danja/chatterbox/links.md

## Chatterbox Links/References

*Some are local copies, see [/reference](https://github.com/danja/chatterbox/tree/master/reference)*

### Formant-based Speech Synthesis
* [Chatterbox](https://github.com/danja/chatterbox/blob/master/reference/Chatterbox-1976.pdf)  [Witten & Madams, 1978]

* [The Source-Filter Model of Speech Production](http://www.phon.ox.ac.uk/jcoleman/source_filter.htm)
* [Formant (Wikipedia)](https://en.wikipedia.org/wiki/Formant)
* [Analysis, synthesis, and perception of voice quality variations among female and male talkers](http://www.fon.hum.uva.nl/david/ma_ssp/doc/Klatt-1990-JAS000820.pdf)
* [Software for a cascade/parallel formant synthesizer](http://www.fon.hum.uva.nl/david/ma_ssp/doc/Klatt-1980-JAS000971.pdf)

*Dennis H. Klatt, the author of the two papers above has [a wealth of other related material](https://www.researchgate.net/scientific-contributions/2033647470_Dennis_H_Klatt)*

* [eSpeakNG](https://github.com/espeak-ng/espeak-ng) - mature open-source project for formant-based speech synthesis
* [Faust](https://faust.grame.fr/)

* [Linear predictive coding](https://en.wikipedia.org/wiki/Linear_predictive_coding)
* Speak & Spell

### Speech
* [Source-Filter Model](https://github.com/danja/chatterbox/blob/master/references/source-filter.pdf)
* [Speech Synthesis and Recognition - local](https://github.com/danja/chatterbox/blob/master/reference/speech-synthesis-and-recognition_book.pdf), [remote copy](https://epdf.pub/queue/speech-synthesis-and-recognition.html) (book)

###  Speech Processing Lecture Slides (very wide in scope, but good summaries of each bit)
From Texas A&M University, CSCE 689-604: Special Topics in Speech Processing, [cource material](http://courses.cs.tamu.edu/rgutier/csce689_s11/)

* L1 : [Course Introduction](http://research.cs.tamu.edu/prism/lectures/sp/l1.pdf)
* L2 : [Speech production and perception](http://research.cs.tamu.edu/prism/lectures/sp/l2.pdf)
* L3 : [Organization of speech sounds](http://research.cs.tamu.edu/prism/lectures/sp/l3.pdf) - good overview slides
* L4 : [Signals and transforms](http://research.cs.tamu.edu/prism/lectures/sp/l4.pdf) (slides)
* L5 : [Digital filters](http://research.cs.tamu.edu/prism/lectures/sp/l5.pdf) (slides)
* L6 : [Short-time Fourier analysis and synthesis](http://research.cs.tamu.edu/prism/lectures/sp/l6.pdf) (slides)
* L7 : [Linear prediction of speech](http://research.cs.tamu.edu/prism/lectures/sp/l7.pdf)
* L8 : [Source estimation](http://research.cs.tamu.edu/prism/lectures/sp/l8.pdf)
* L9 : [Cepstral analysis](http://research.cs.tamu.edu/prism/lectures/sp/l9.pdf)
* L10 : [Probability, statistics, and estimation theory](http://research.cs.tamu.edu/prism/lectures/sp/l10.pdf)
* L11 : [Pattern recognition principles](http://research.cs.tamu.edu/prism/lectures/sp/l11.pdf)
* L12 : [Template matching](http://research.cs.tamu.edu/prism/lectures/sp/l12.pdf)
* L13 : [hidden Markov models](http://research.cs.tamu.edu/prism/lectures/sp/l13.pdf)
* L14 : [Refinements for HMMs](http://research.cs.tamu.edu/prism/lectures/sp/l14.pdf)
* L15 : [Large vocabulary continuous speech recognition](http://research.cs.tamu.edu/prism/lectures/sp/l15.pdf)
* L16 : [Speaker recognition](http://research.cs.tamu.edu/prism/lectures/sp/l16.pdf)
* L17 : [Speech synthesis (front-end)](http://research.cs.tamu.edu/prism/lectures/sp/l17.pdf)
* L18 : [Speech synthesis (back end)](http://research.cs.tamu.edu/prism/lectures/sp/l18.pdf)
* L19 : [Prosodic modification of speech](http://research.cs.tamu.edu/prism/lectures/sp/l19.pdf)
* L20 : [Voice Conversion](http://research.cs.tamu.edu/prism/lectures/sp/l20.pdf)
* L21 : [HTK](http://research.cs.tamu.edu/prism/lectures/sp/l21.pdf) (HTK is a toolkit for building Hidden Markov Models primarily designed for building speech recognizers)

* [Voice Acoustics](https://newt.phys.unsw.edu.au/jw/speech.html)
* [Voice Acoustics: an introduction](https://newt.phys.unsw.edu.au/jw/voice.html)
* [Phonetics](https://home.cc.umanitoba.ca/~krussll/phonetics/index.html)

* [Acoustic structure of consonants](http://www.phon.ox.ac.uk/jcoleman/consonant_acoustics.htm)
* [Gunnar Fant Publications](http://www.speech.kth.se/gunnarfant/publications.html)
* [A Four-Parameter Model of Glottal Flow](https://www.researchgate.net/publication/243630331_A_Four-Parameter_Model_of_Glottal_Flow) (*LF-model*)
* [The LF-model revisited. Transformations and frequency domain analysis](https://citeseerx.ist.psu.edu/viewdoc/download?doi=10.1.1.184.6321&rep=rep1&type=pdf)
* [LF-frequency domain analysis](http://www.speech.kth.se/prod/publications/files/qpsr/1996/1996_37_2_135-138.pdf)

* [Are Measured Differences Between the Formants of Men, Women and Children Due to FO Differences?](https://core.ac.uk/download/pdf/85221943.pdf)
* [Relative contribution of envelope and fine structure to the subcortical encoding of noise-degraded speech](https://asa.scitation.org/doi/10.1121/1.4965248)
* [Temporal information in speech: acoustic, auditory and linguistic aspects](https://royalsocietypublishing.org/doi/pdf/10.1098/rstb.1992.0070)
* [Dynamics: The Third Dimension of Speech](https://www.audiologyonline.com/articles/dynamics-third-dimension-speech-813)

* [Spectral balance as an acoustic correlate of linguistic stress](https://www.researchgate.net/publication/14340446_Spectral_tilt_as_an_acoustic_correlate_of_linguistic_stress)
* [Detection of shouted speech in noise: Human and machine](https://users.aalto.fi/~jpohjala/publications/JASMAN13342377_1.pdf)
* [Sopranos: resonance tuning and vowel changes](https://newt.phys.unsw.edu.au/jw/soprane.html)
* [FORENSIC ANALYSIS OF THE AUDIBILITY OF FEMALE SCREAMS ](http://www.audioforensics.com/PDFs/AES122_Scream.pdf)
* [Modeling and Analyzing the Vocal TRact under Normal and Stressful Talking Conditions](https://arxiv.org/pdf/1707.00149.pdf)
* [On chaotic nature of speech signals](https://www.researchgate.net/publication/23678739_On_chaotic_nature_of_speech_signals)

## DSP
**Online Books**
* [Mathematics of the Discrete Fourier Transform (DFT)](https://ccrma.stanford.edu/~jos/mdft/)
* [Introduction to Digital Filters](https://ccrma.stanford.edu/~jos/filters/) (uses MATLAB)
* [Physical Audio Signal Processing](https://ccrma.stanford.edu/~jos/pasp/)
* [Spectral Audio Signal Processing](https://ccrma.stanford.edu/~jos/sasp/)

### Wavetables etc.
* [the_synth](https://github.com/dzlonline/the_synth)
* [Alias-Free Digital Synthesis of Classic Analog Waveforms](https://ccrma.stanford.edu/~stilti/papers/blit.pdf)
* [Table Lookup Oscillators Using Generic Integrated Wavetables](http://mtg.upf.edu/node/485)

* [Pink Noise bits](https://dsp.stackexchange.com/questions/322/pink-1-f-pseudo-random-noise-generation/56820#56820)

### Filters
* [Digital Filters For Music Synthesis](https://github.com/danja/chatterbox/blob/master/reference/karmafx_digitalfilters.pdf)
* [musicdsp.org](https://www.musicdsp.org/)
* [KVR Forum](https://www.kvraudio.com/forum/)
* [Biquads](https://www.earlevel.com/main/2003/02/28/biquads/) (blog - a lot of other stuff)
* [The digital state variable filter](https://www.earlevel.com/main/2003/03/02/the-digital-state-variable-filter/)
* [Introduction to Digital Filters with Audio Applications](https://ccrma.stanford.edu/~jos/filters/)
* [A Collection of Useful C++ Classes for Digital Signal Processing](https://github.com/vinniefalco/DSPFilters)
* [DSP Tips & Tricks](https://web.archive.org/web/20070427190833/http://www.cspl.umd.edu/spm/tips-n-tricks/)

* [Cytomic technical papers](https://cytomic.com/technical-papers) (includes the derivation of SvfLinearTrapOptimised2)
* [Common-DSP](https://github.com/FredAntonCorvest/Common-DSP) (includes implementation of SvfLinearTrapOptimised2)

### Fixed-point maths
* [Fixed Point Math Library for C](https://sourceforge.net/p/fixedptc/)
* [related thread on StackOverflow](https://stackoverflow.com/questions/10067510/fixed-point-arithmetic-in-c-programming)

### ESP32
* [ESP32 Projects & Tutorials](https://randomnerdtutorials.com/projects-esp32/)
* [ESP32 Peripherals](https://randomnerdtutorials.com/esp32-pinout-reference-gpios/)
* [ESP32 Pinout Reference: Which GPIO pins should you use?](https://randomnerdtutorials.com/esp32-pinout-reference-gpios/)
* [The best input and output pins on the NodeMCU ESP32 and ESP8266 (YouTube)](https://www.youtube.com/watch?v=c0tMGlJVmkw)
* [ESP32 ADC – Read Analog Values with Arduino IDE](https://randomnerdtutorials.com/esp32-adc-analog-read-arduino-ide/)
* [Using the ESP32 ADC and some of its more advanced functions (YouTube)](https://www.youtube.com/watch?v=RlKMJknsNpo)
* [esp32-dac](https://github.com/wjslager/esp32-dac)
* [ESP32-ADC-Accuracy-Improvement-function](https://github.com/G6EJD/ESP32-ADC-Accuracy-Improvement-function)
* [Polynomial Regression Data Fit](https://arachnoid.com/polysolve/)

* [ESP-IDF Hello World](https://exploreembedded.com/wiki/Hello_World_with_ESP32_Explained)
* [ESP-IDF ADC API](https://docs.espressif.com/projects/esp-idf/en/latest/api-reference/peripherals/adc.html)
* [ESP-DSP](https://github.com/espressif/esp-dsp)
* [ESP32 Parallel Programming](https://home.roboticlab.eu/en/iot-open/getting_familiar_with_your_hardware_rtu_itmo_sut/esp/esp_parallel_programming)
* [Debouncing a Button Press using Interrupts](https://www.switchdoc.com/2018/04/esp32-tutorial-debouncing-a-button-press-using-interrupts/)

### ESP32/HTTP
* [ESP32 Arduino: Asynchronous HTTP web server](https://techtutorialsx.com/2017/12/01/esp32-arduino-asynchronous-http-webserver/)
* [ESP32 Web Server using SPIFFS (SPI Flash File System)](https://randomnerdtutorials.com/esp32-web-server-spiffs-spi-flash-file-system/)
* [Install ESP32 Filesystem Uploader in Arduino IDE](https://randomnerdtutorials.com/install-esp32-filesystem-uploader-arduino-ide/)
* [Async Web Server for ESP8266 and ESP32](https://github.com/me-no-dev/ESPAsyncWebServer)
* [Async TCP Library for ESP32](https://github.com/me-no-dev/AsyncTCP)
* [ESP32 HTTP webserver: receiving textual data in websocket](https://techtutorialsx.com/2018/08/23/esp32-http-webserver-receiving-textual-data-in-websocket/)

### DAC
[UDA1334ATS Info](https://lcav.gitbook.io/dsp-labs/passthrough/audio-io/dac)

/// unsorted

https://www2.ling.su.se/staff/hartmut/T_1988_phonetica.pdf

http://www.speech.kth.se/gunnarfant/publications.html

http://www.phon.ox.ac.uk/jcoleman/consonant_acoustics.htm

https://forum.arduino.cc/index.php?topic=38153.0

https://www.quora.com/How-can-an-IoT-device-connect-to-a-WiFi-network-without-manually-entering-the-password-or-using-a-cable-to-another-device

https://create.arduino.cc/projecthub/chnry/ocs-2-a-digital-semi-modular-synthesizer-733ba9

https://www.soundonsound.com/techniques/synthesizing-wind-instruments?amp

----

https://makezine.com/2017/04/11/how-to-set-up-your-own-lab/

http://www.radiofreerobotron.net/blog/2016/07/06/how-to-zero-delay-state-variable-filter-part-3/

https://www.musicdsp.org/en/latest/Filters/23-state-variable.html

https://music.stackexchange.com/questions/74483/what-does-a-wave-with-all-even-harmonics-sound-like

https://randomnerdtutorials.com/esp32-web-server-spiffs-spi-flash-file-system/

https://techtutorialsx.com/2018/02/03/esp32-arduino-async-server-controlling-http-methods-allowed/amp/

https://randomnerdtutorials.com/esp32-web-server-spiffs-spi-flash-file-system/

https://randomnerdtutorials.com/esp32-web-server-spiffs-spi-flash-file-system/

https://makezine.com/2017/04/11/how-to-set-up-your-own-lab/

https://www.google.com/search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

https://www.fischl.de/projects/

https://newt.phys.unsw.edu.au/jw/graphics/Wolfe-et-al-Source-Filter.png

https://newt.phys.unsw.edu.au/jw/voice.html

https://newt.phys.unsw.edu.au/jw/voice.html

https://en.wikibooks.org/wiki/Sound_Synthesis_Theory/Oscillators_and_Wavetables

https://www.musicdsp.org/en/latest/Synthesis/244-direct-pink-noise-synthesis-with-auto-correlated-generator.html

http://www.fon.hum.uva.nl/praat/

https://github.com/espressif/esp-idf/tree/f91080637c054fa2b4107192719075d237ecc3ec/examples/peripherals/i2s

https://swphonetics.com/praat/introduction/

https://dsp.stackexchange.com/questions/5959/add-odd-even-harmonics-to-signal

https://www.reddit.com/r/esp32/comments/f6kjqh/serial_speed_too_slow_add_a_100nf_capacitor/

https://www.bbc.co.uk/news/av/world-50116478/thirty-mummies-in-wooden-coffins-found-in-egypt
