danja/chatterbox/future/modules.md

displays:

https://www.banggood.com/2_4-Inch-TFT-LCD-Shield-240320-Touch-Board-Display-Module-With-Pen-For-UNO-p-1171082.html

https://www.banggood.com/Geekcreit-3_2-Inch-MEGA2560-Display-Module-HX8357B-480x320-TFT-LCD-Screen-p-1566668.html
