danja/chatterbox/src/phonetics/ipa-examples.md

that	ðæt
difficult	ˈdɪfɪkəlt
you	ju:
which	wɪtʃ
their	ðeəʳ
about	əˈbaʊt
photo	ˈfoʊtoʊ
should	ʃʊd
people	ˈpi:pəl
also	ˈɔ:lsoʊ
between	bɪˈtwi:n
many	ˈmeni
thicker	ˈθɪkəʳ
child	tʃaɪld
hear	hɪəʳ
system	ˈsɪstəm
group	gru:p
number	ˈnʌmbəʳ

however	haʊˈevəʳ
another	əˈnʌðəʳ
again	əˈgen
world	wɜ:ʳld
area	ˈeəriə
psychology	saɪˈkɒlədʒi
course	kɔ:ʳs
company	ˈkʌmpəni
under	ˈʌndəʳ
problem	ˈprɒbləm
never	ˈnevəʳ
service	ˈsɜ:ʳvɪs
something	ˈsʌmθɪŋ
place	pleɪs
point	pɔɪnt
provide	prəˈvaɪd
large	lɑ:ʳdʒ
general	ˈdʒenərəl

always	ˈɔ:lweɪz
next	nekst
quick	kwɪk
nervous	ˈnɜ:ʳvəs
local	ˈloʊkəl
during	ˈdjʊərɪŋ
although	ɔ:lˈðoʊ
who	hu:
example	ɪgˈzæmpəl
rather	ˈræðəʳ
social	ˈsoʊʃəl
write	raɪt
percent	pəʳ ˈsent
guest	gest
both	boʊθ
every	ˈevri
month	mʌnθ
important	ɪmˈpɔ:ʳtənt

head	hed
information	ɪnfəʳ ˈmeɪʃən
question	ˈkwestʃən
business	ˈbɪznɪs
power	ˈpaʊəʳ
change	tʃeɪndʒ
move	mu:v
book	bʊk
development	dɪˈveləpmənt
young	jʌŋ
national	ˈnæʃənəl
water	ˈwɔ:təʳ
yet	jet
perhaps	pəʳ ˈhæps
until	ʌnˈtɪl
control	kənˈtroʊl
include	ɪnˈklu:d
believe	bɪˈli:v

allow	əˈlaʊ
stand	stænd
idea	aɪˈdi:ə
character	ˈkærɪktəʳ
result	rɪˈzʌlt
happen	ˈhæpən
friend	frend
carry	ˈkæri
awful	ˈɔ:fəl
early	ˈɜ:ʳli
view	vju:
himself	hɪmˈself
xerox	ˈzɪərɒks
report	rɪˈpɔ:ʳt
political	pəˈlɪtɪkəl
law	lɔ:
ghost	goʊst
modest	ˈmɒdɪst

person	ˈpɜ:ʳsən
once	wʌns
police	pəˈli:s
lose	lu:z
position	pəˈzɪʃən
industry	ˈɪndəstri
major	ˈmeɪdʒəʳ
build	bɪld
language	ˈlæŋgwɪdʒ
international	ɪntəʳ ˈnæʃənəl
else	els
yeah	jeə
center	ˈsentəʳ
enough	ɪˈnʌf
calm	kɑ:m
color	ˈkʌləʳ
lure	lʊəʳ
knife	naɪf
