danja/chatterbox/analysis/praat-fooood.png

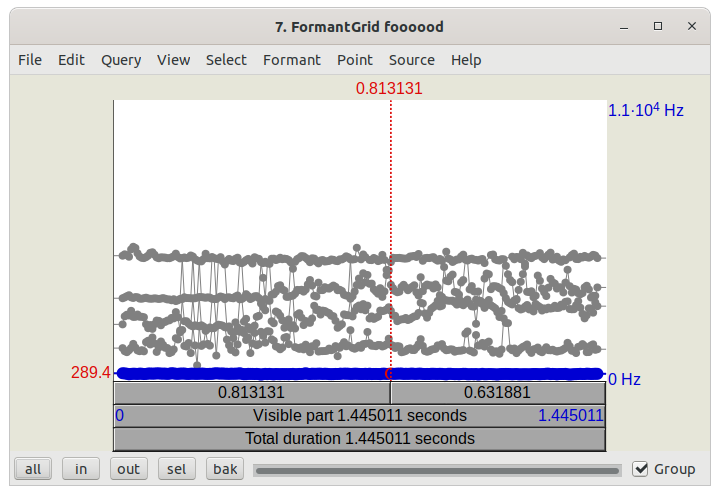
analysis/praat-fooood.png
