danja/chatterbox/analysis/praat-ooo-autocorrelation.png

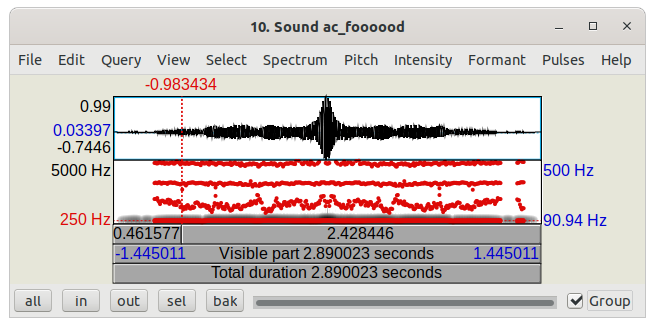
analysis/praat-ooo-autocorrelation.png
