danja/chatterbox/media/4d88490a-8cd4-49ad-87e7-2d5451d0ee30.jpeg

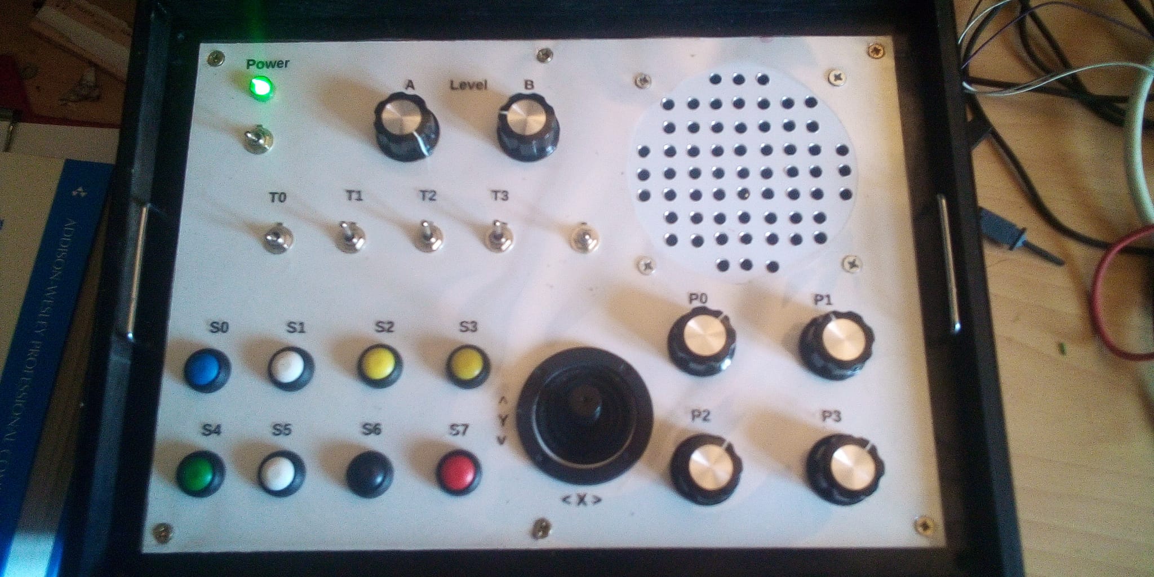
media/4d88490a-8cd4-49ad-87e7-2d5451d0ee30.jpeg
