danja/chatterbox/media/06231e58-6e3f-4843-a5ed-ce382f4466a9.jpeg

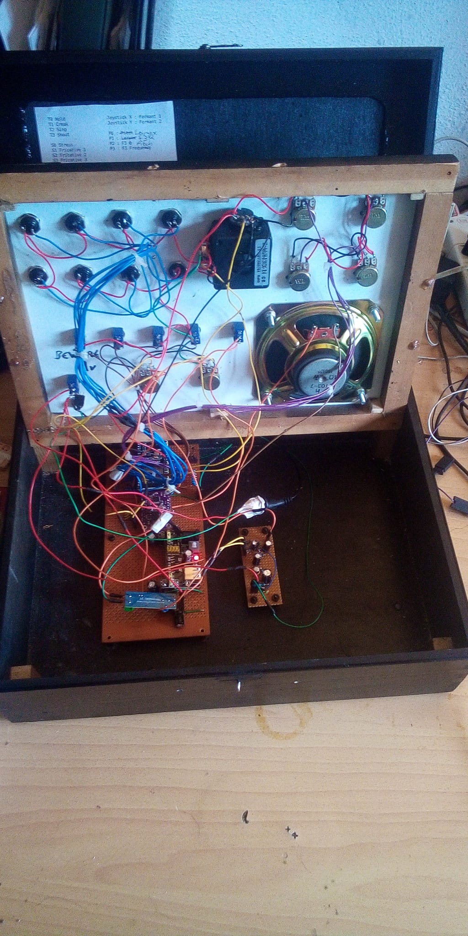
media/06231e58-6e3f-4843-a5ed-ce382f4466a9.jpeg
