danja/chatterbox/media/back-of-front-panel.jpeg

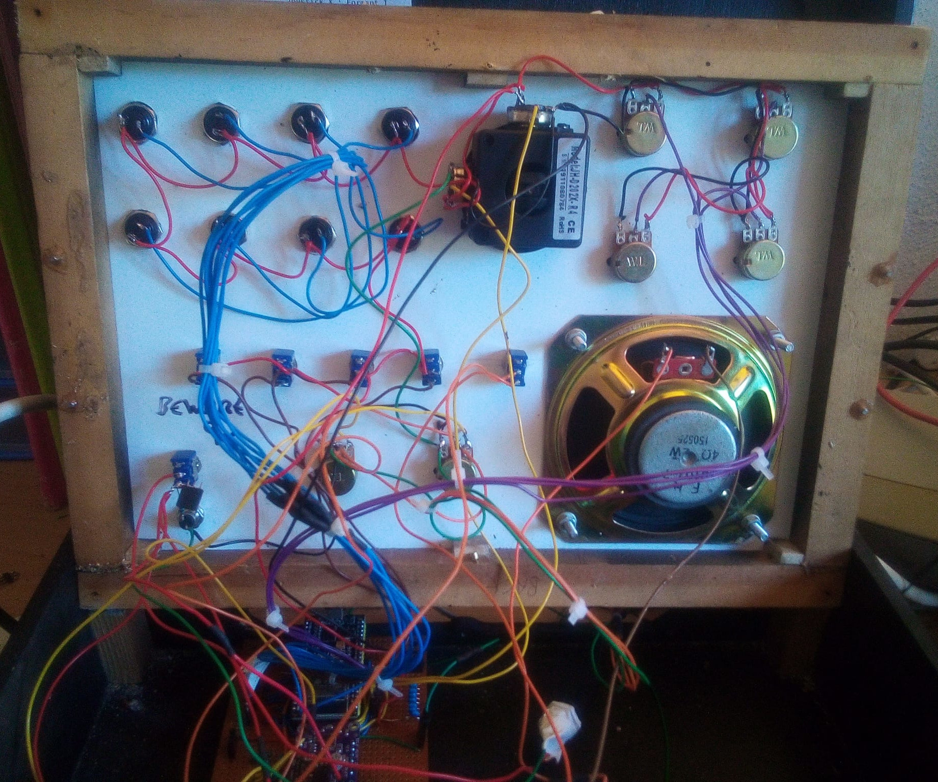
media/back-of-front-panel.jpeg
