danja/chatterbox/media/chatterbox_1.0-claudio.jpg

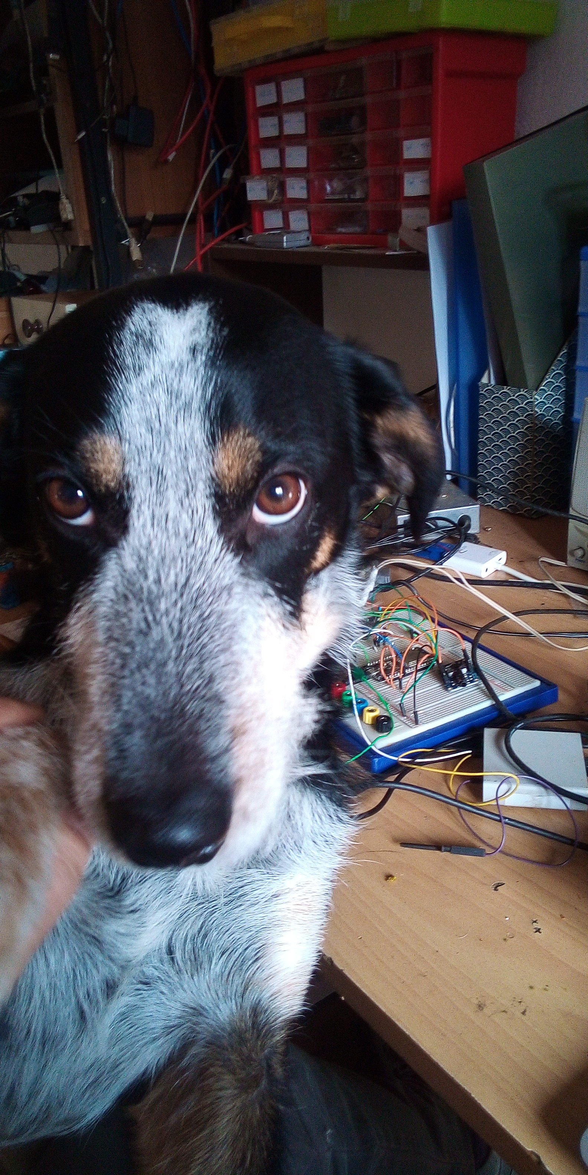
media/chatterbox_1.0-claudio.jpg
