danja/chatterbox/media/conf.jpg

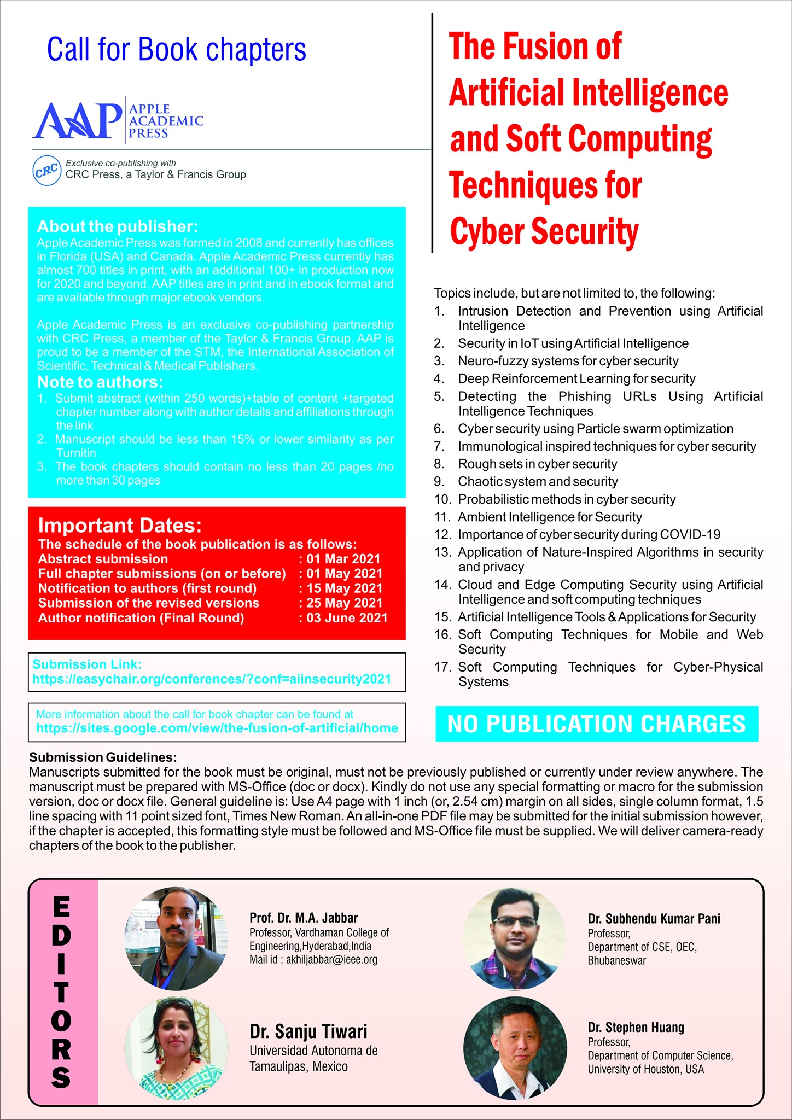
media/conf.jpg
