danja/chatterbox/media/front-panel_2021-02-07.jpeg

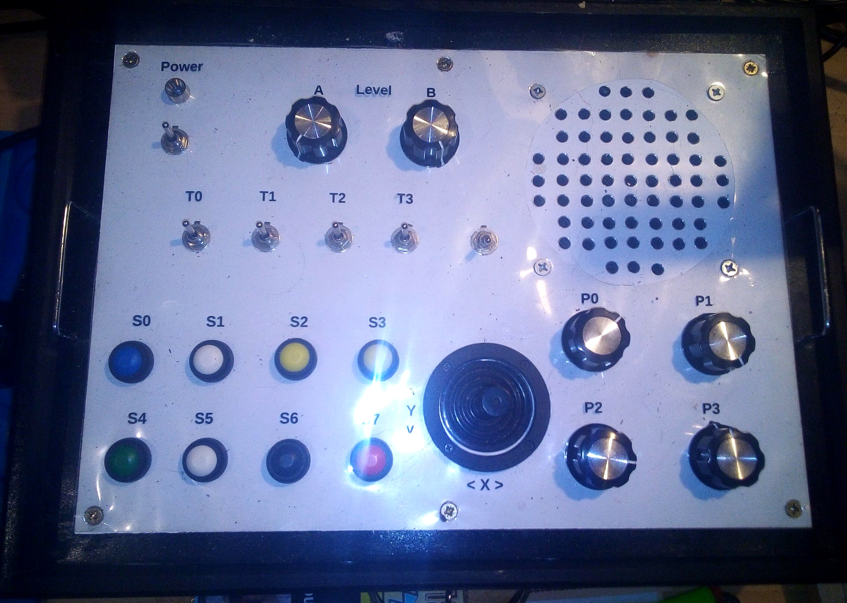
media/front-panel_2021-02-07.jpeg
