danja/chatterbox/media/front-panel_v1.png

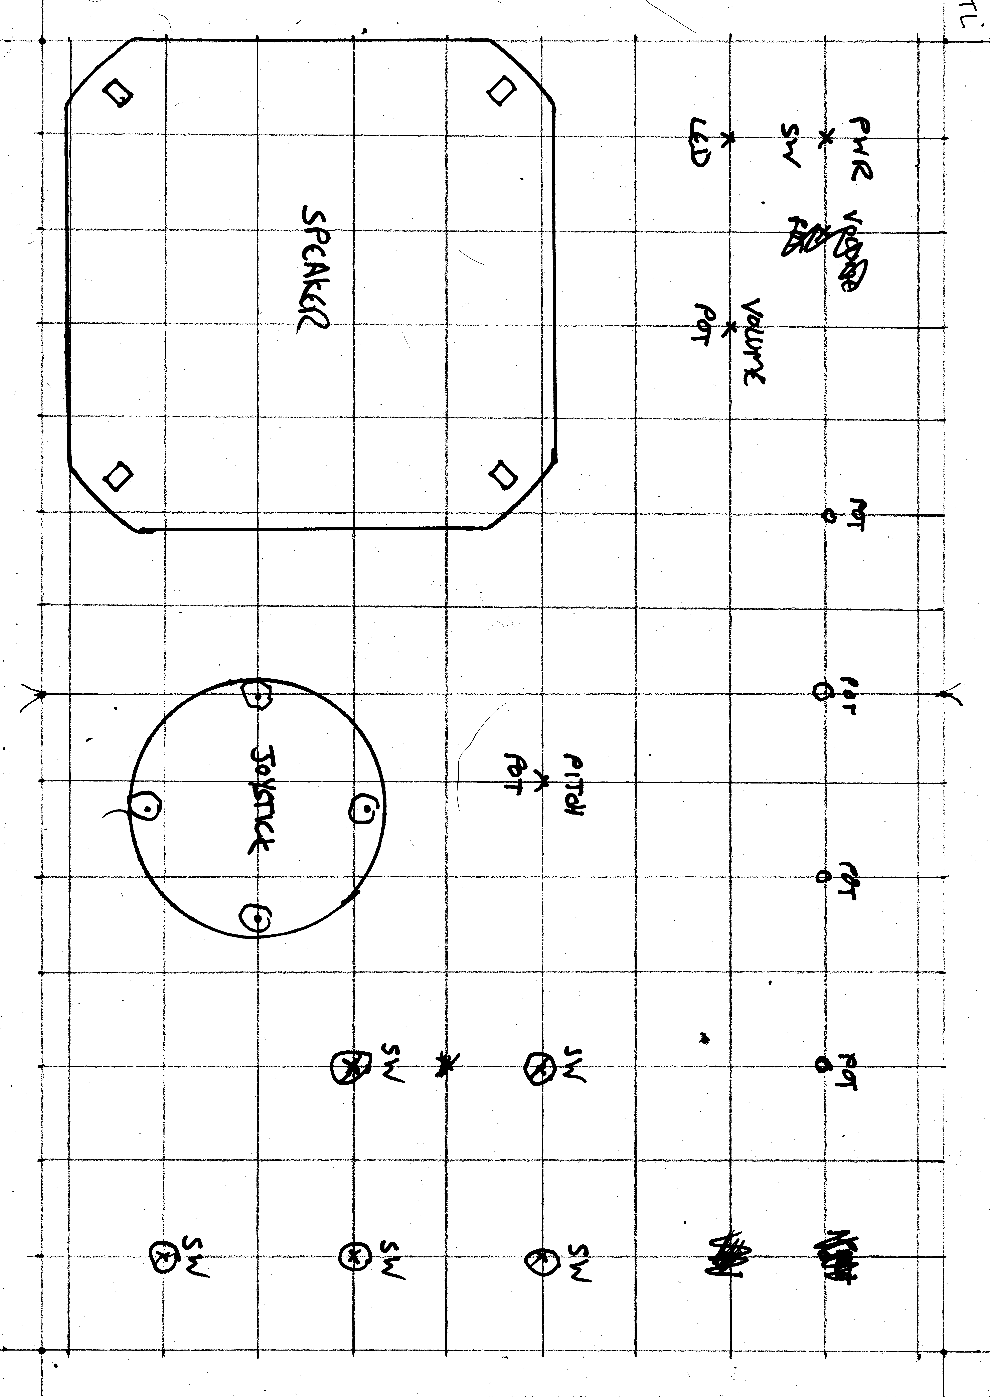
media/front-panel_v1.png
