danja/chatterbox/media/headless-circuit-board_2021-02-07.jpeg

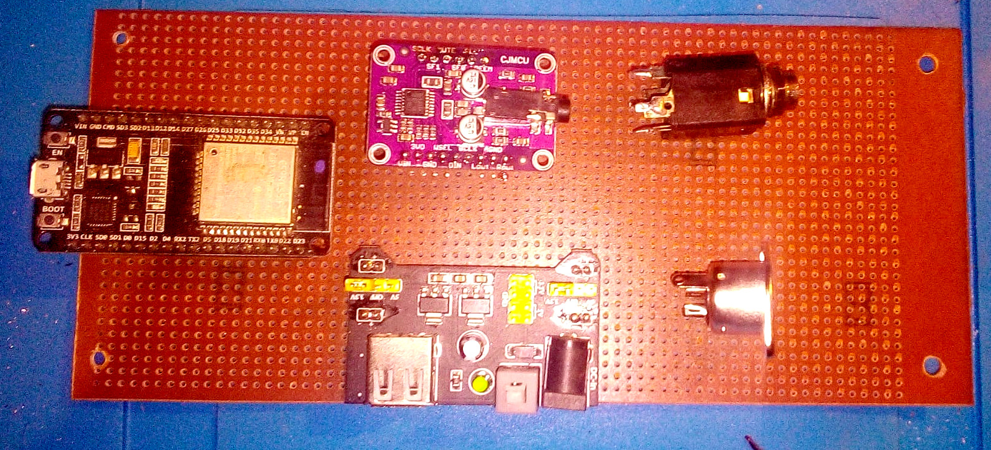
media/headless-circuit-board_2021-02-07.jpeg
