danja/chatterbox/media/jtag-board_2021-02-07.jpeg

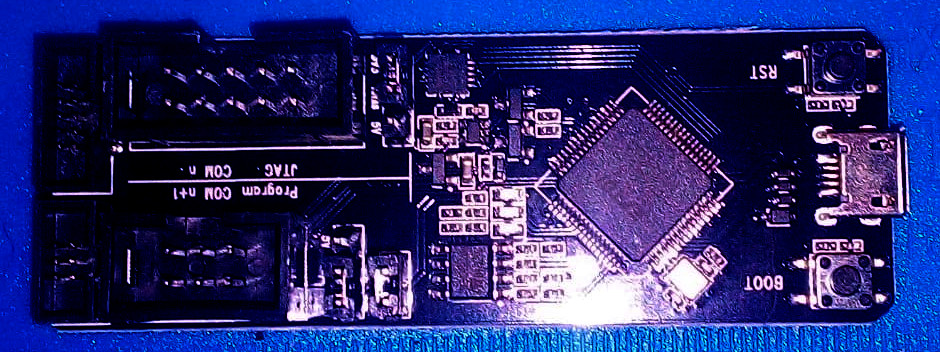
media/jtag-board_2021-02-07.jpeg
