danja/chatterbox/media/larynx-1.png

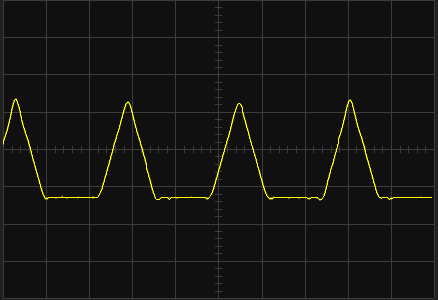
media/larynx-1.png
