danja/chatterbox/media/mixer.gif

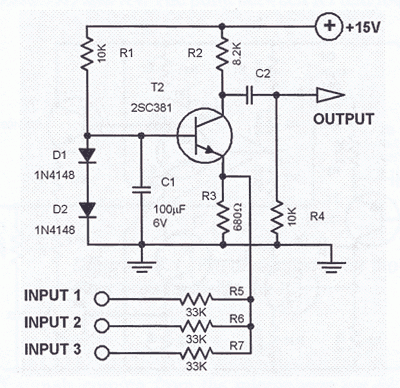
media/mixer.gif
