danja/chatterbox/media/prototype-5-switches.jpeg

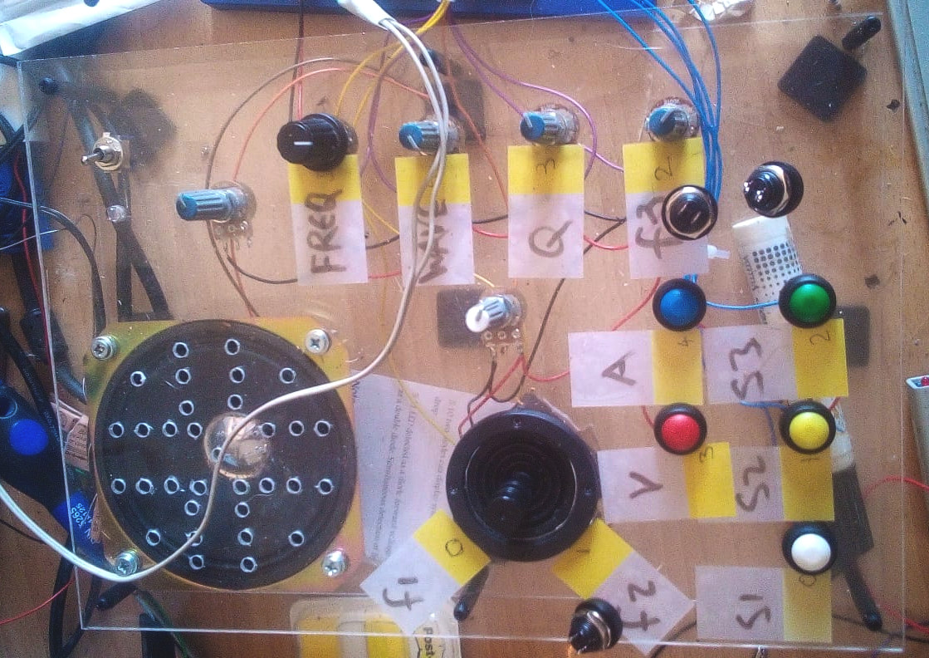
media/prototype-5-switches.jpeg
