danja/chatterbox/media/prototype-12-switches.jpeg

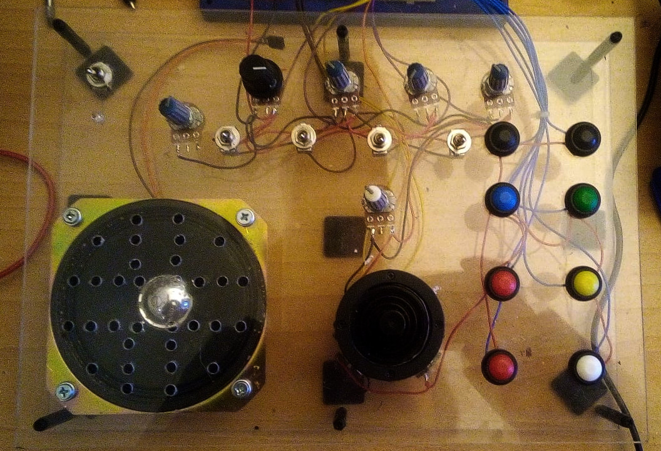
media/prototype-12-switches.jpeg
