danja/chatterbox/media/prototype-spaghetti.jpeg

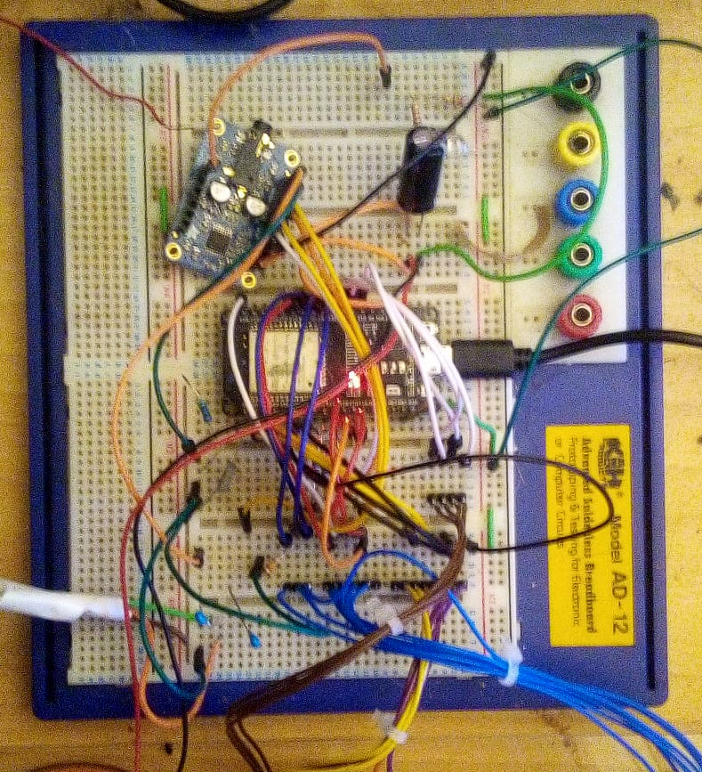
media/prototype-spaghetti.jpeg
