danja/chatterbox/media/quiet-woman.jpg

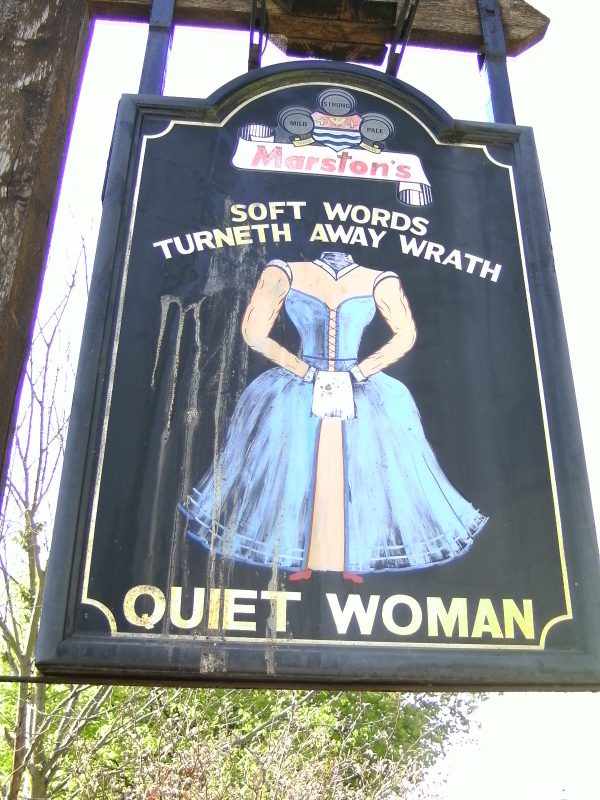
media/quiet-woman.jpg
