danja/chatterbox/media/Screenshot from 2020-05-11 20-49-50.png

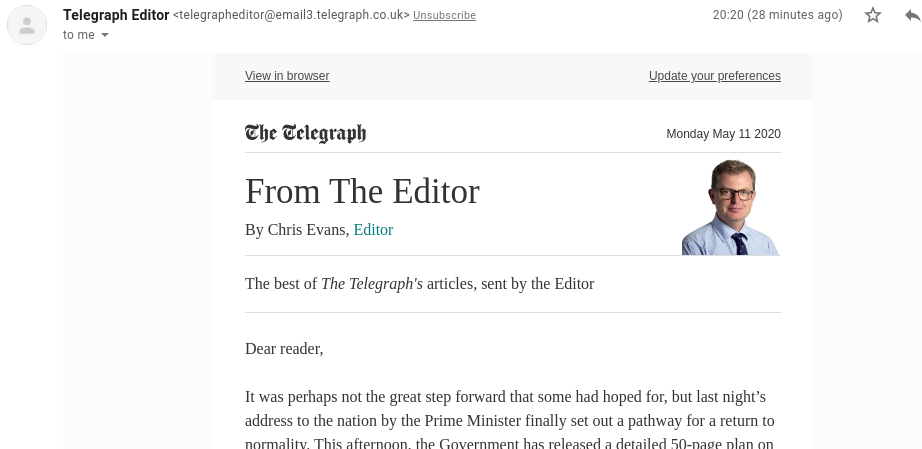
media/Screenshot from 2020-05-11 20-49-50.png
