danja/chatterbox/media/Screenshot from 2020-05-12 01-05-00.png

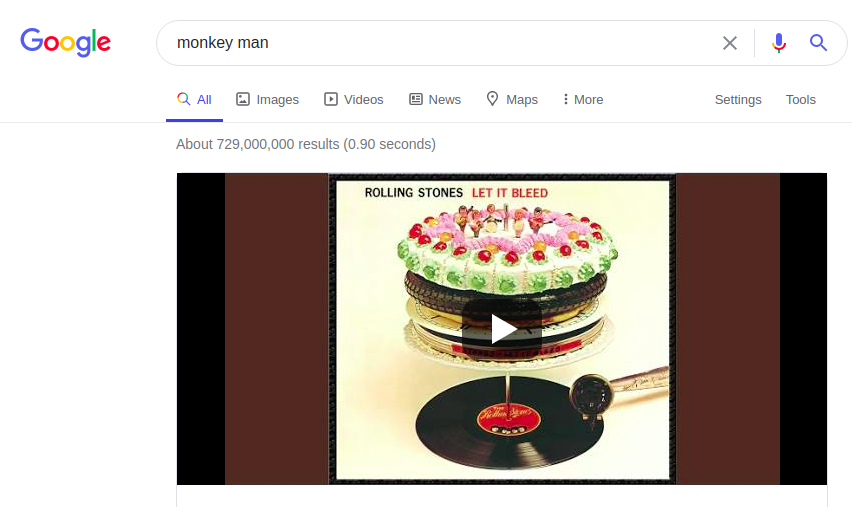
media/Screenshot from 2020-05-12 01-05-00.png
