danja/chatterbox/media/Screenshot from 2020-06-10 19-36-39.png

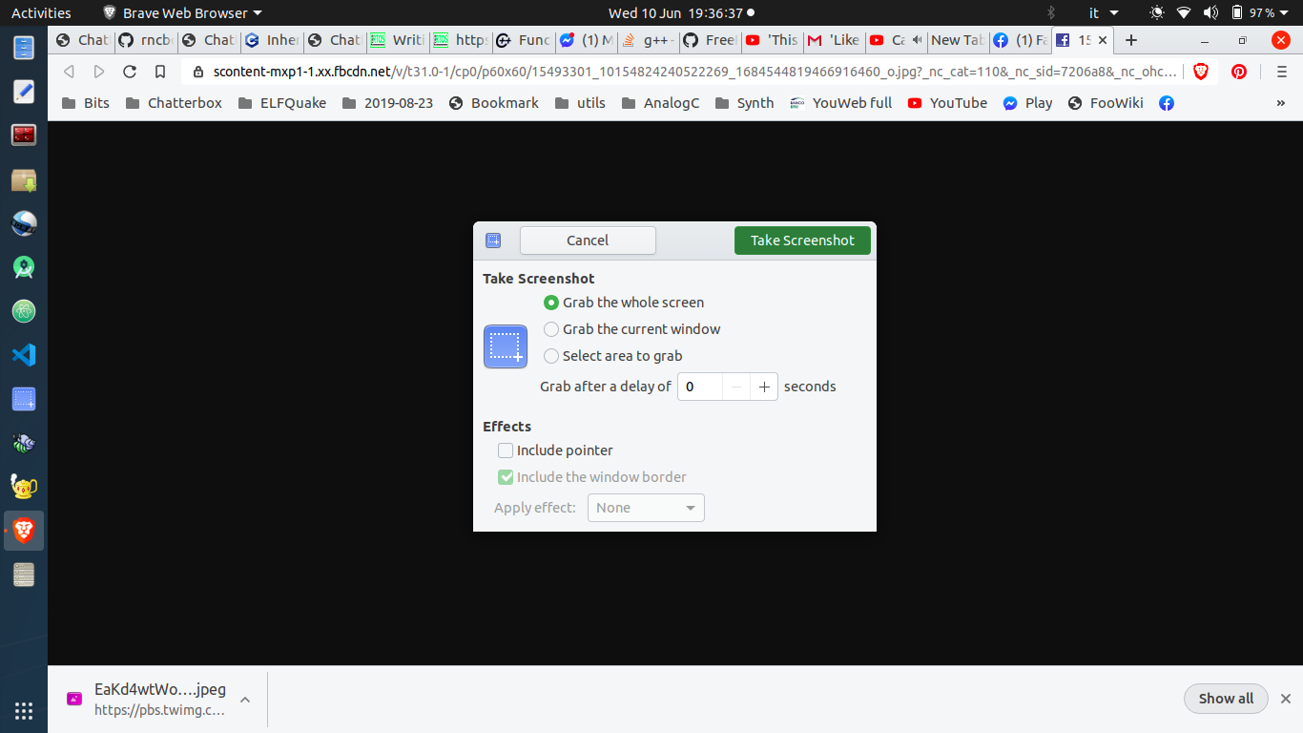
media/Screenshot from 2020-06-10 19-36-39.png
