danja/chatterbox/media/tidza-sawyed.jpg

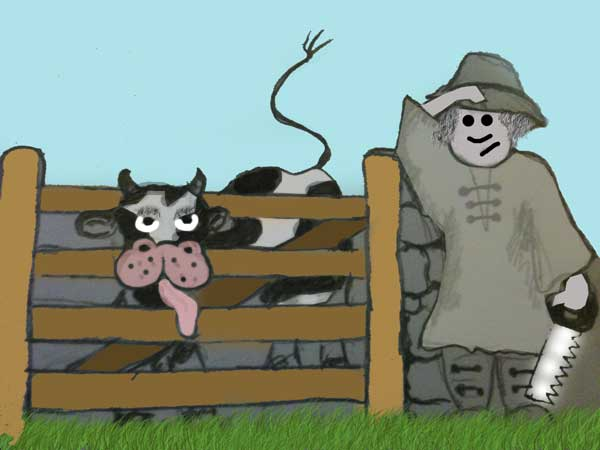
media/tidza-sawyed.jpg
