danja/chatterbox/media/wave-glitch.png

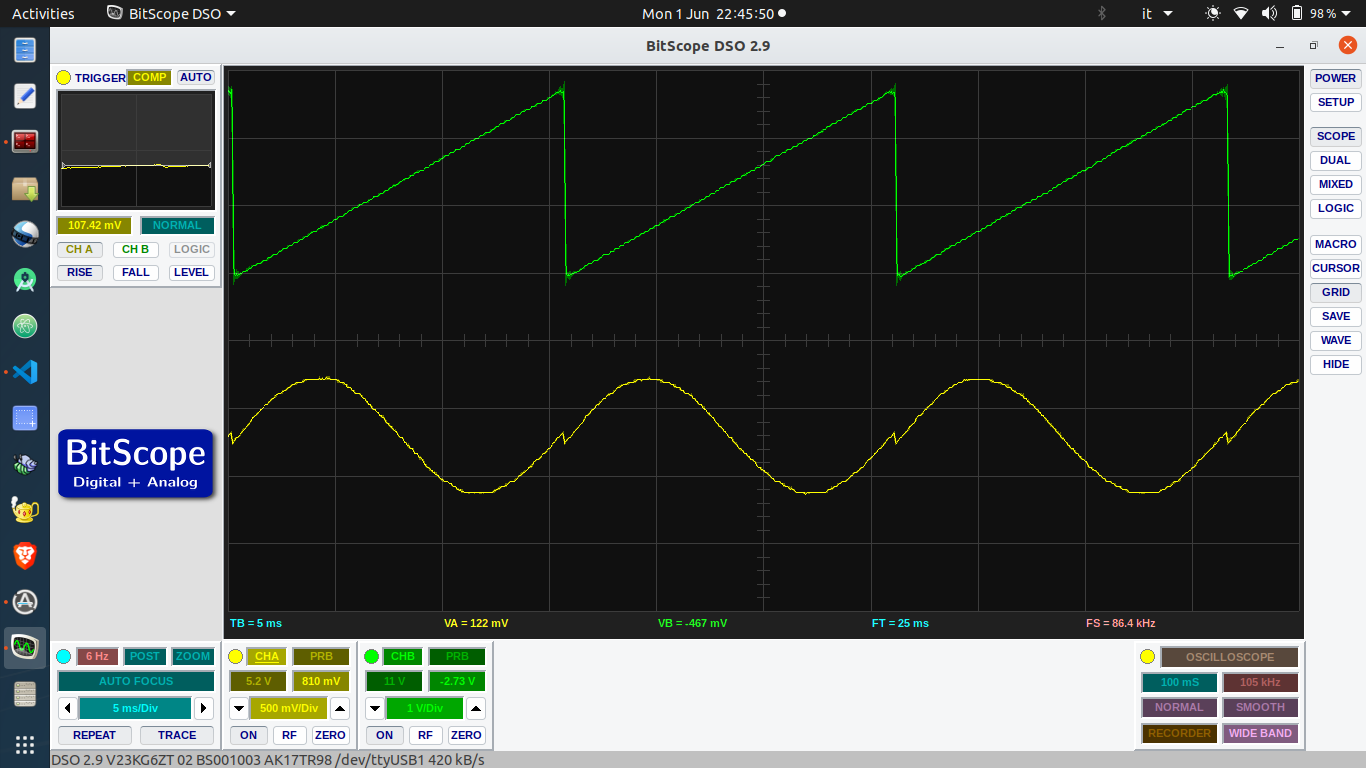
media/wave-glitch.png
