danja/chatterbox/reference/amplifier-circuit.jpeg

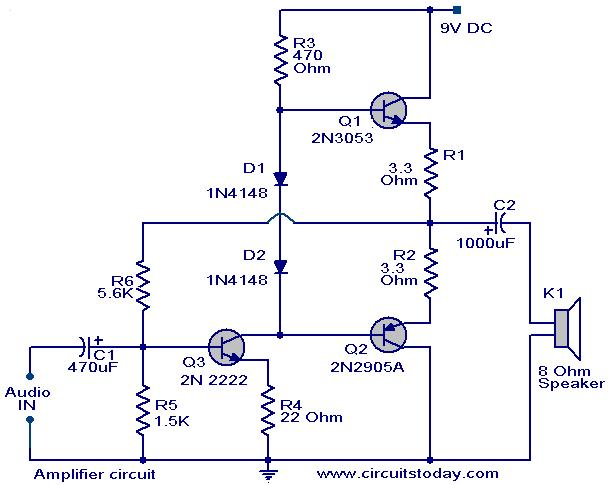
reference/amplifier-circuit.jpeg
