danja/chatterbox/reference/art-artwork-cavemen-prehistoric-golden_age-art-gra060704_low.jpg

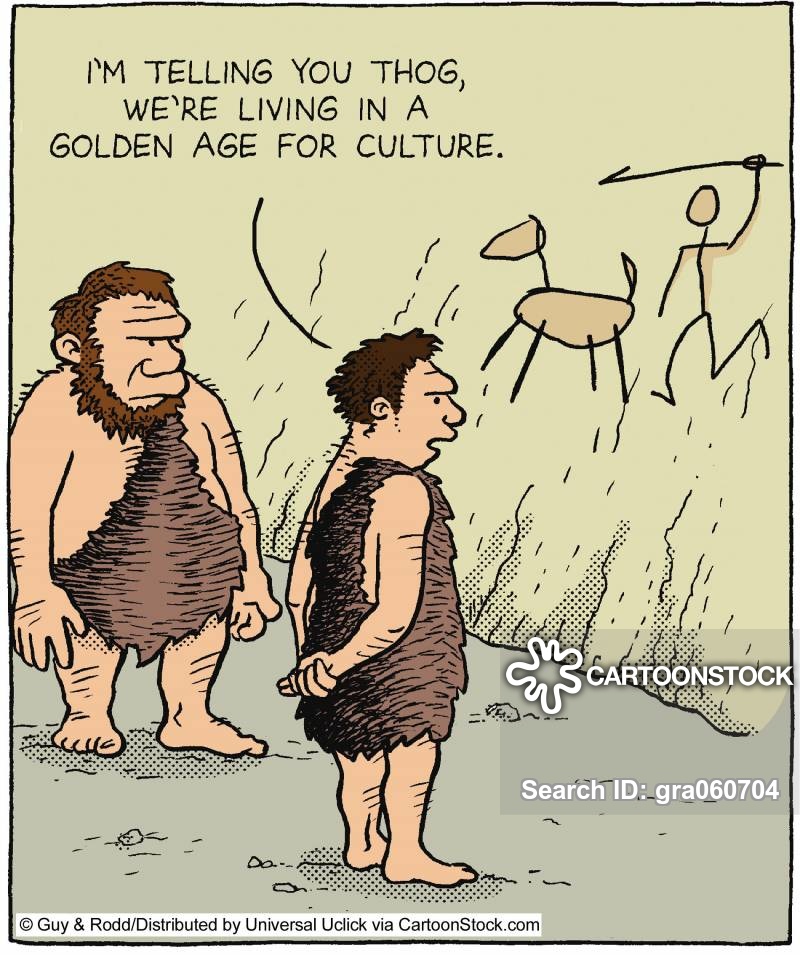
reference/art-artwork-cavemen-prehistoric-golden_age-art-gra060704_low.jpg
