danja/chatterbox/reference/bidirectonal-mosfet-level-shifter.png

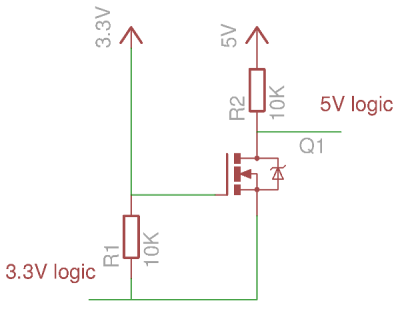
reference/bidirectonal-mosfet-level-shifter.png
