danja/chatterbox/reference/Composition-Distinctive-Feature-Segments-English.jpg

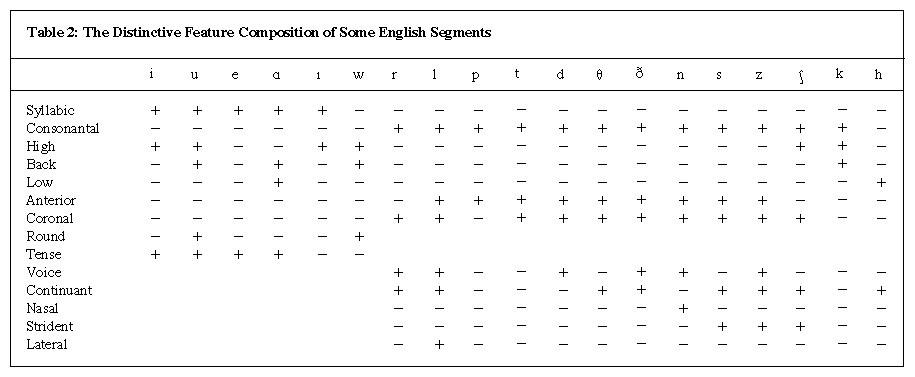
reference/Composition-Distinctive-Feature-Segments-English.jpg
