danja/chatterbox/reference/ESP32-pinout-AZDelivery.jpg

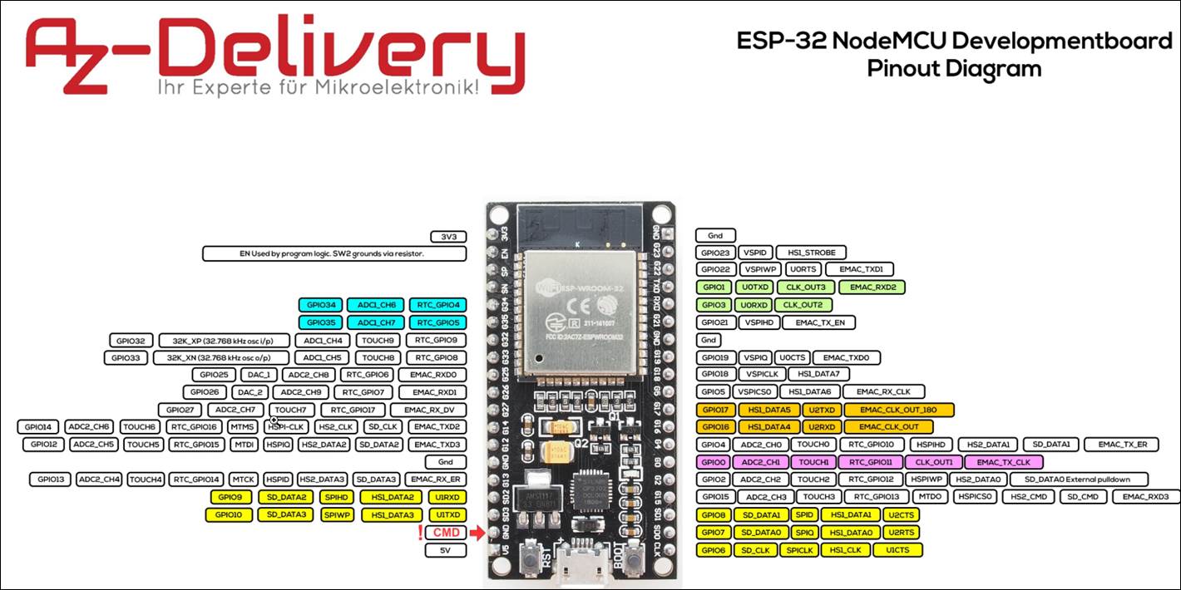
reference/ESP32-pinout-AZDelivery.jpg
