danja/chatterbox/reference/formant-freqs-wikipedia.png

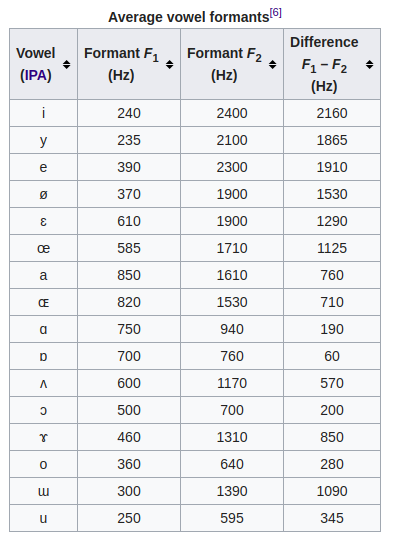
reference/formant-freqs-wikipedia.png
