danja/chatterbox/reference/ipa-examples.jpg

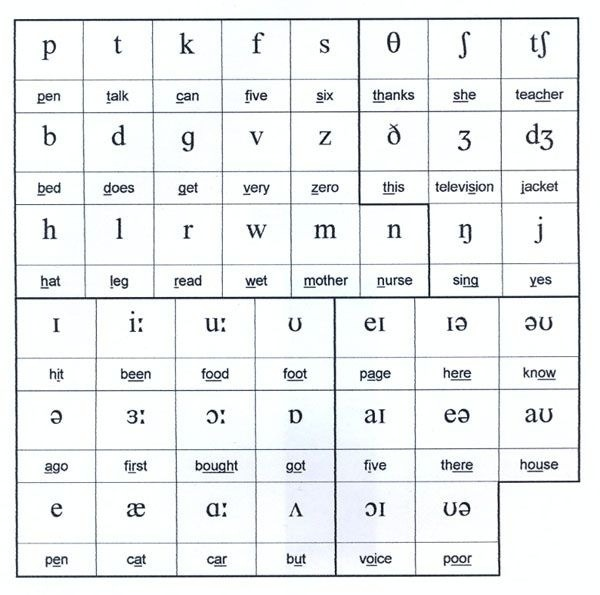
reference/ipa-examples.jpg
