danja/chatterbox/reference/ipa-sampa.png

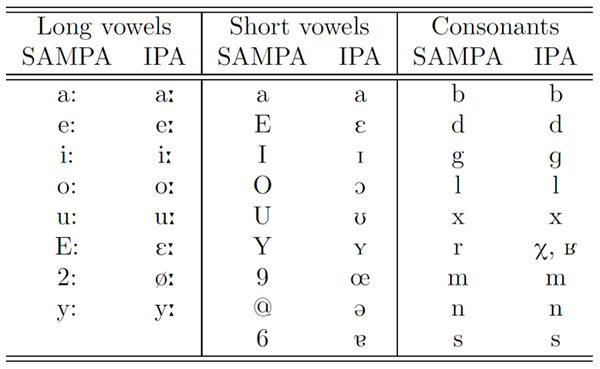
reference/ipa-sampa.png
