danja/chatterbox/reference/phoneme-classes2.png

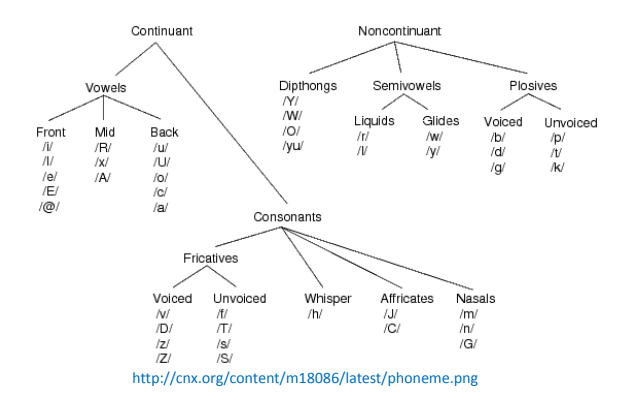
reference/phoneme-classes2.png
