danja/chatterbox/reference/sound-classes.png

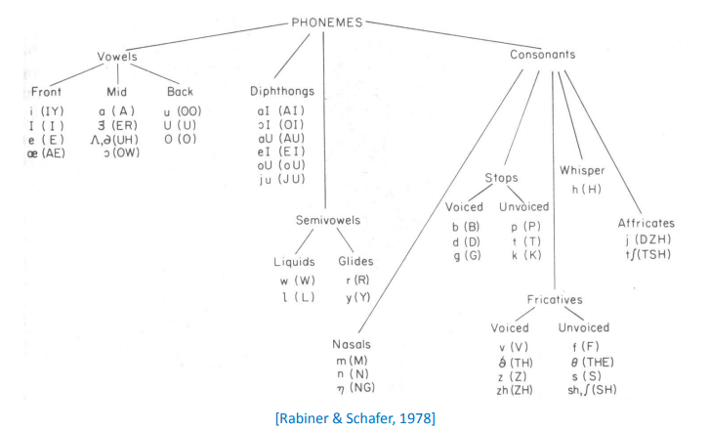
reference/sound-classes.png
