danja/chatterbox/reference/speech-importance-function.jpg

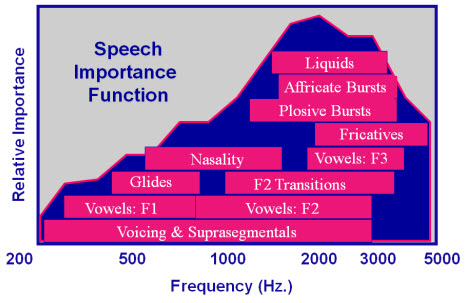
reference/speech-importance-function.jpg
