danja/chatterbox/reference/unnamed.jpg

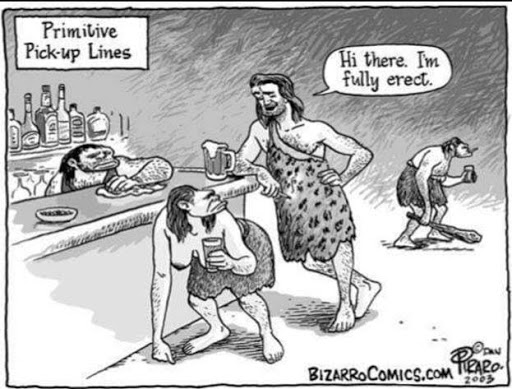
reference/unnamed.jpg
