danja/chatterbox/reference/vowel-formants.jpg

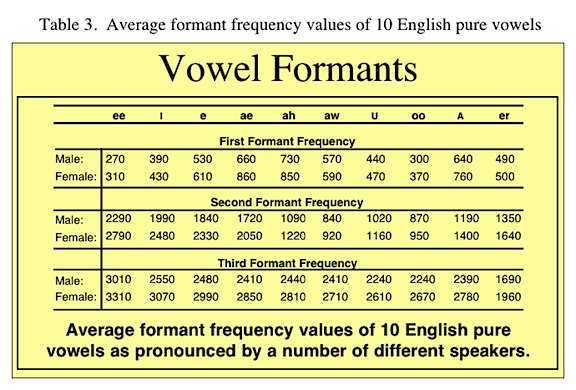
reference/vowel-formants.jpg
