danja/chatterbox/manual/bom.md

## Chatterbox Parts List

| Part# | Qty | Description  |
| --- |:---:| -----:|
| M1 | | ESP32 Module |
