danja/chatterbox/manual/index.md

## Chatterbox Manual

*I'm writing as I go along, might be a while yet*

* Introduction

*the speech sample can be modeled as a weighted sum of the 𝑝 previous samples plus some excitation contribution*

Many speech systems use Linear prediction (eg. speak & spell) where in effect all the parameters are applied in one big equation. The approach taken here is more modular, reminiscent of (subtractive) analog music synthesis.  

[Modeling the Human Voice](model.md)

* [Controls](controls.md)

### Hardware
* [Parts List](bom.md)

### Software
* [Design](design.md)

[Glossary](glossary.md)
