danja/chatterbox/manual/glossary.md

## Glossary

// TODO need at least one link for each entry
// TODO scour existing glossaries

### A
* ASR - Automatic Speech Recognition
### B
### C
### D
* DTW - Dynamic Time Warping
### E
### F
### G
### H
* HMM - Hidden Markov Model
* HTK is a toolkit for building Hidden Markov Models primarily designed for building speech recognizers
### I
### J
### K
### L
###### Larynx - the voice box, an organ in the top of the neck involved in breathing, producing sound and protecting the trachea against food aspiration. The larynx houses the vocal folds and is used to generate voiced sounds. W:[Larynx](https://en.wikipedia.org/wiki/Larynx)
* Lombard Effect
### M
### N
### O
### P
* ###### Pharynx - the part of the throat behind the mouth and nasal cavity, and above the esophagus and larynx (ie. both food & air go through it). W:[Pharynx](https://en.wikipedia.org/wiki/Pharynx)
### Q
### R
### S
* Spectral Tilt - the overall slope of the power spectral density. Can be Spectral balance as an acoustic correlate of linguistic stress
* Stress - a structural property of a word that specifies which syllable in the word is, *in some sense*, stronger than any of the others
### T
### U
W:[Uvula](https://en.wikipedia.org/wiki/Palatine_uvula)
### V
* Voiced
### W
### X
### Y
### Z
