danja/chatterbox/media/printer-shrink.png

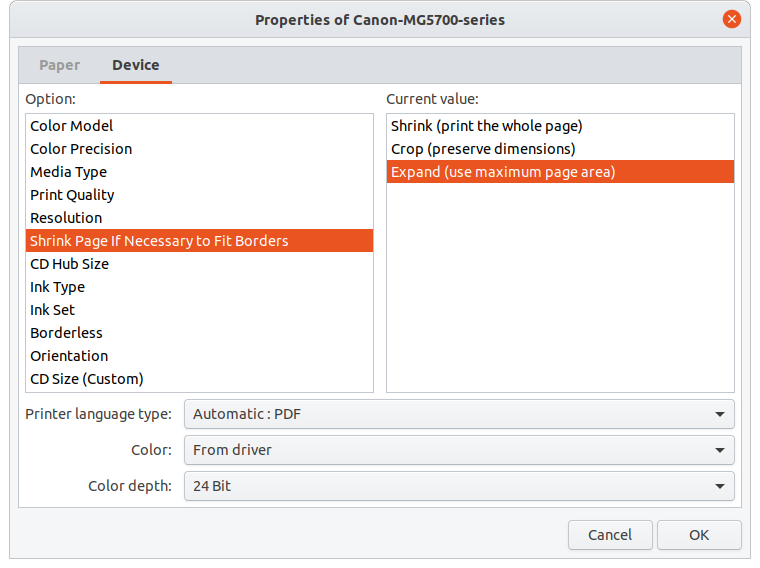
media/printer-shrink.png
