danja/chatterbox/todo.md

## Chatterbox ToDo

*I've hardly been using this, left here just as a last-ditch reminder...*

*2020-07-02*

**MIDI**

* Wired interface
  * Output
  * Input

* BLE ??

**Research**
* check github markdown for checkboxes/todo lists

**Documentation**
* Hardware block diagram
* Schematic
* Manual

**Refactoring**
* make filter etc. naming more regular across Web interface
* archive unused sig gen block

**Signal Generation**
* try real time larynx wave gen

**Module Wiring**
* implement some kind of connection class

**Web Interface**
* basic comms, static page
* read values from controls
* write values to controls
* WebSockets

**Command Line Interface**
 
* Write out phonemes as numbers
* formants from my voice

**Controls**
* Envelope Generator for switches
* linearise pots - lookup table? polynomial?

**Filters**
* implement range setting
* try other filter algorithms
* add filters for noise

**MIDI Interface**
* hardware
* MIDI in
* MIDI out
