danja/chatterbox/src/misc-experiments/http-test/http-test.ino

#include "WiFi.h"
#include "ESPAsyncWebServer.h"
 
const char* ssid = "TP-LINK_AC17DC";
const char* password =  "33088297";
 
AsyncWebServer server(80);
 
void setup(){
  Serial.begin(115200);
 
  WiFi.begin(ssid, password);
 
  while (WiFi.status() != WL_CONNECTED) {
    delay(1000);
    Serial.println("Connecting to WiFi..");
  }
 
  Serial.println(WiFi.localIP());
 
  server.on("/hello", HTTP_GET, [](AsyncWebServerRequest *request){
    request->send(200, "text/plain", "Hello World");
  });
 
  server.begin();
}

void loop(){}
