danja/chatterbox/(commit log)

2020-03-02 preparing for filter experiments
2020-03-02 initial filter play, so far unsuccessful
2020-03-03 filters starting to work...
2020-03-06 figuring out filters
2020-03-23 minimal ESP32 WebSocket server code added, it works!
2020-03-26 playing with speech analysis
    [untitled.csv]
2020-03-27 added more switches, controls to websocket working
2020-03-27 playing with added switches
2020-03-28 added hold switch
2020-03-29 playing with new switches : chaotic sig gen. Switch logic is currently buggy
2020-04-01 some progress on nasal & sing switches
2020-04-10 pitch control from browser! primitive, but working
2020-04-12 pulled out noise gen bits as seperate C files
    [chatterbox_1.1.0.cpp]
2020-04-12 turned Shapers and NoiseMaker into external classes
    [chatterbox_1.1.0.cpp]
2020-04-13 working on Switch objects
2020-04-14 hold toggle now moved over to Switch class
2020-04-14 switches are now objects
2020-05-07 mistake in dispatcher corrected
    [chatterbox_1.1.0.cpp]
2020-06-01 shifting filters to Processor wrapper
2020-06-01 fricative filter to Processor wrapped
2020-06-09 output thread pulled out into own class
2020-06-17 moving switches to separate class
2020-06-18 moved switches into a separate class
2020-07-04 level tweaks
    [chatterbox-partitions.csv]
2020-07-07 moved filter gains into filters
2020-07-08 moved control thread to it's own class
2020-08-06 MIDI mod wheel to larynx not quite right
2020-10-10 fixed little HOLD error
    [chatterbox_1.1.0.cpp]
2020-12-01 adding sweep for calibration/testing
2020-12-11 fiddling with calibrate
2020-12-14 calibrate sweep working
2020-12-14 calibration test value bits roughed out
2021-02-18 pulled out switches & pots to Manual class
2021-02-24 samplerate back to 22000
